ShashlikTB/TBAmplifierCard/README.md

Test Beam Amplifier Board

We plan on using the TBAmp board at the test beam on July 22-August 19 as a method of 
reading out several individual SiPM channels and passing the rest of the signals through
the board on the PADE card. 

The master branch has the non-mirrored version of the Amplifier board that pulls 
channels 0,2,4, and 6. The other branches contain other versions of the card and 
have a similar description. 

A version of this card got sent to manufacturing on 7-7-2014, here's hoping it works.
