ShashlikTB/TBAmplifierCard/(commit log)

2014-06-02 Beginning work on the Test Beam Amplifier Board, early commit because I'm going to test some automation of manipulating the schematic using external software
    [FastAmpOutput.sch, TestBeamAmplifierBoard.sch]
2014-06-02 Ok, I've got some of the basic layout done
    Next steps:
    Wire up the amplifier circuit and copy x 4
    Find out which channels we want to break out
    [TestBeamAmplifierBoard.sch]
2014-06-18 Schematic complete (mostly, may have bugs) initial layout of parts on pcb, no connecting bits
    [FastAmpOutput.sch, TestBeamAmplifierBoard.kicad_pcb, TestBeamAmplifierBoard.sch]
2014-06-20 Schematic has been pretty much finished, on the pcb layout I've got everything positioned in a "this will probably work" kind of setup (it has much potential for improvement). Next up, routing the li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
    [FastAmpOutput.sch, TestBeamAmplifierBoard.kicad_pcb, TestBeamAmplifierBoard.sch]
2014-06-20 Added a few more decoupling caps and other assorted filtering to the Vcc line for the amplifiers.
    [FastAmpOutput.sch, TestBeamAmplifierBoard.kicad_pcb, TestBeamAmplifierBoard.sch]
2014-06-20 Finished about half the wiring, think I have a better way of doing things so I'm saving here and trying the other approach.
    [FastAmpOutput.sch, TestBeamAmplifierBoard.kicad_pcb, TestBeamAmplifierBoard.sch]
2014-07-01 Modified the schematic to make the layout much cleaner and redid the pcb.
    Currently at the optimize for space stage.
    [FastAmpOutput.sch, TestBeamAmplifierBoard.kicad_pcb, TestBeamAmplifierBoard.sch]
2014-07-02 Combined GND and COMM_N into just COMM_N, have everything connected and space a little minimized. I have an idea I'd like to try. If I increase the board layers I think I can move the Amplifier secti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
    [FastAmpOutput.sch, TestBeamAmplifierBoard.kicad_pcb, TestBeamAmplifierBoard.sch]
2014-07-02 6-Layer attempt to shrink board, have parts mostly placed in this commit.
    [TestBeamAmplifierBoard.kicad_pcb]
2014-07-02 Doing the signal routing from top of board down, it looks like this approach will work but may take a while to finish.
    [TestBeamAmplifierBoard.kicad_pcb]
2014-07-02 Finished half of the routing from one edge to the other
    [TestBeamAmplifierBoard.kicad_pcb]
2014-07-02 Finished routing 6-layer version of Test Beam Amp. PCB, looks ok, still need to check everything though.
    [TestBeamAmplifierBoard.kicad_pcb]
2014-07-03 Changed the size of the board to match the pade board, starting on re-routing everything...again.
    [TestBeamAmplifierBoard.kicad_pcb]
2014-07-03 Finished layout with change in size to match PADE board and power connector moved to middle
    [TestBeamAmplifierBoard.kicad_pcb]
2014-07-03 Made all of the component values visible, cleaned up some traces
    [TestBeamAmplifierBoard.kicad_pcb]
2014-07-05 Added COMM_N2
    [TestBeamAmplifierBoard.kicad_pcb]
2014-07-05 Separated out traces to attempt to reduce crosstalk
    [TestBeamAmplifierBoard.kicad_pcb]
2014-07-07 Version sent for manufacturing
    [TestBeamAmplifierBoard.kicad_pcb]
